CarlFK/pj/README.md

Pi JTAG hatish.
<https://github.com/CarlFK/pj/wiki>
rn_image_picker_lib_temp_75ff1ffa-18d0-46a6-9b67-185ed4aa6dda
