CarlFK/pj/project/pj.kicad_pcb

## KiCad design project/pj.kicad_pcb (2024-12-12)

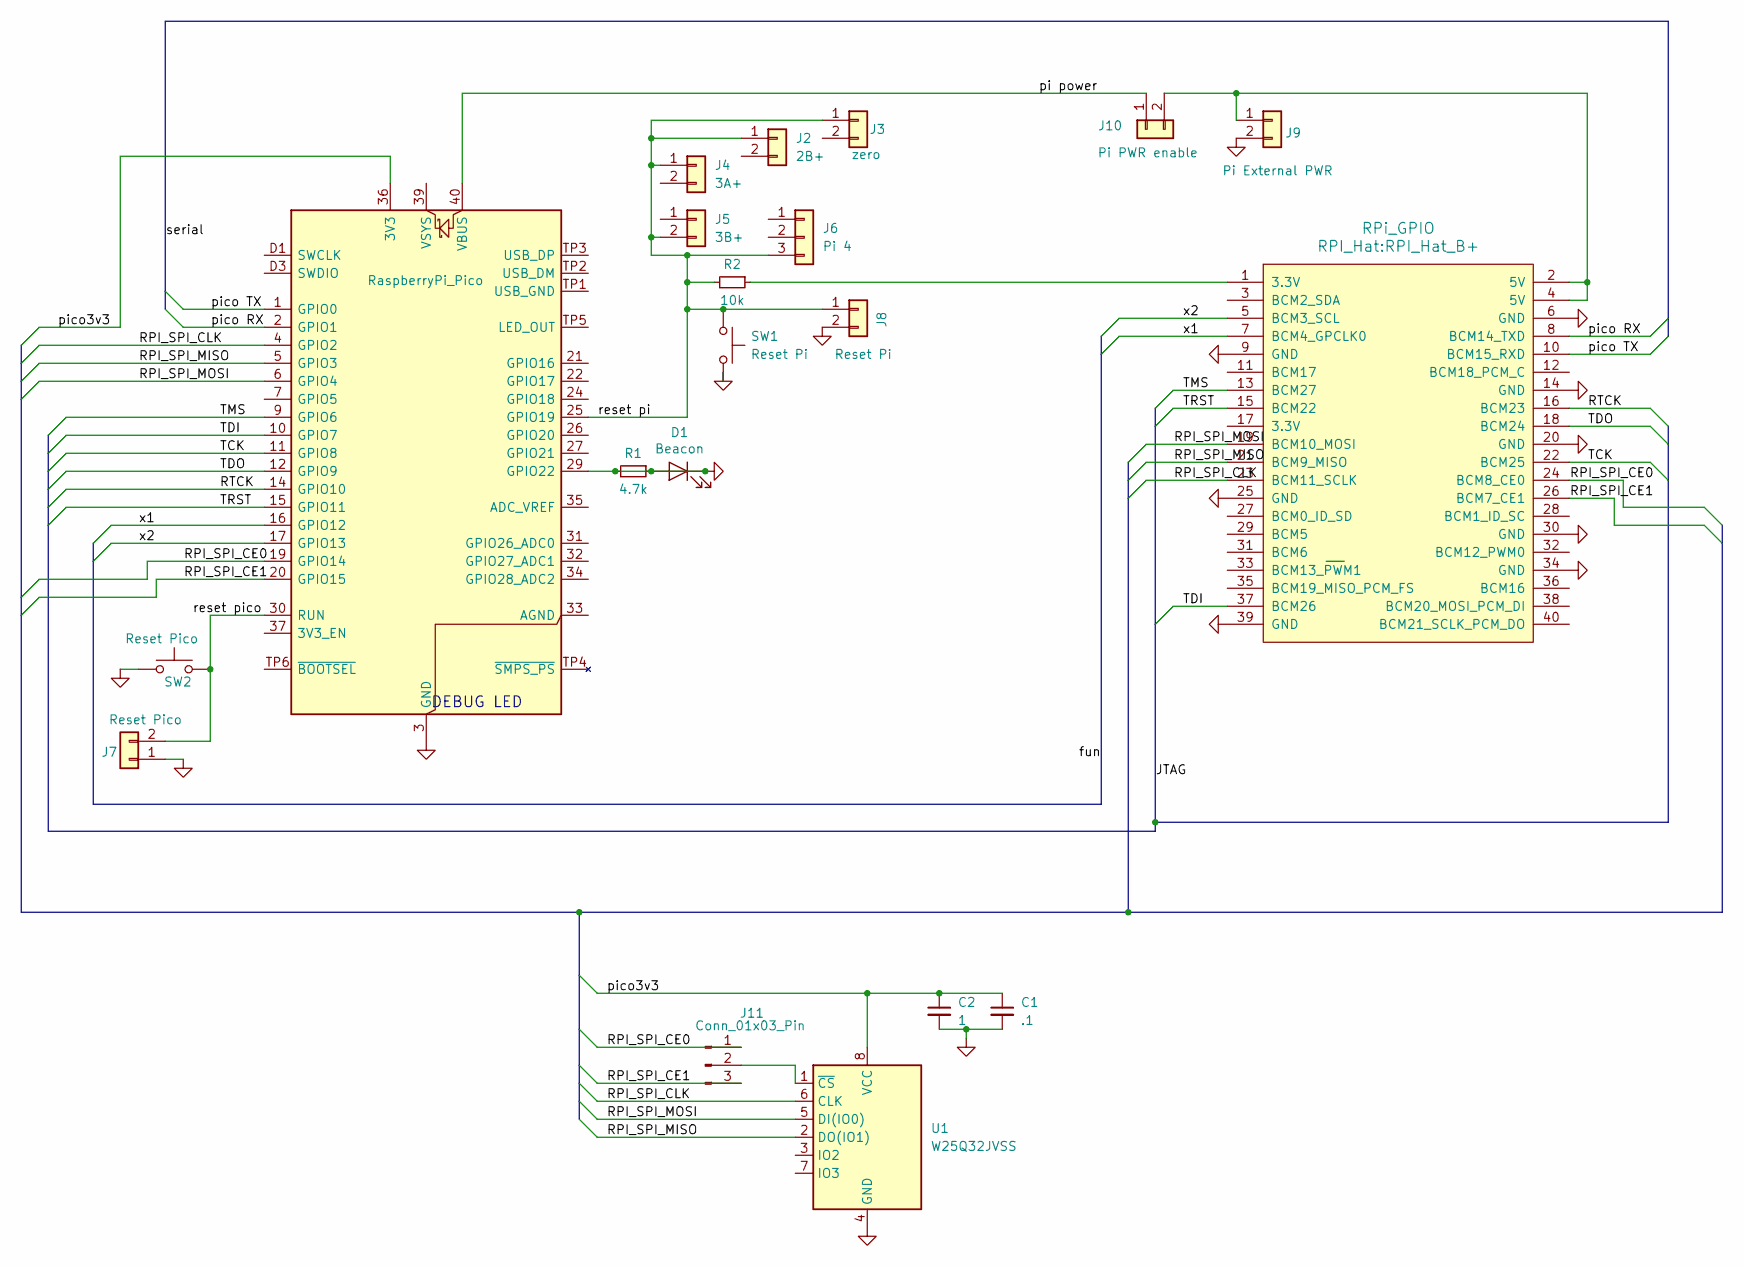
[picture p1: schematic pj.kicad_sch]

Parts:
A1: RaspberryPi_Pico; RaspberryPi_Pico_Common
C1: .1; C_0603_1608Metric_Pad1.08x0.95mm_HandSolder
C2: 1; C_0603_1608Metric_Pad1.08x0.95mm_HandSolder
D1: Beacon; LED_0603_1608Metric
J1: RPi_GPIO; RPI_Hat_B+
J2: 2B+; PinSocket_1x02_P2.54mm_Vertical
J3: zero; PinSocket_1x02_P2.54mm_Vertical
J4: 3A+; PinSocket_1x02_P2.54mm_Vertical
J5: 3B+; PinSocket_1x02_P2.54mm_Vertical
J6: Pi 4; PinSocket_1x03_P2.54mm_Vertical
J7: Reset Pico; PinHeader_1x02_P2.54mm_Vertical
J8: Reset Pi; PinHeader_1x02_P2.54mm_Vertical
J9: Pi External PWR; PinHeader_1x02_P2.54mm_Vertical
J10: Pi PWR enable; SolderJumper-2_P1.3mm_Bridged2Bar_Pad1.0x1.5mm
J11: Conn_01x03_Pin; PinHeader_1x03_P2.54mm_Vertical
R1: 4.7k; R_0603_1608Metric
R2: 10k; R_0603_1608Metric
SW1: Reset Pi; SW_PUSH_6mm_H4.3mm
SW2: Reset Pico; SW_PUSH_6mm_H4.3mm
U1: W25Q32JVSS; SOIC-8_5.23x5.23mm_P1.27mm

Connections:
/RPI_SPI_CE0: A1.19 (GPIO14), J1.24 (BCM8_CE0), J11.1
/RPI_SPI_CE1: A1.20 (GPIO15), J1.26 (BCM7_CE1), J11.3
/RPI_SPI_CLK: A1.4 (GPIO2), J1.23 (BCM11_SCLK), U1.6 (CLK)
/RPI_SPI_MISO: A1.5 (GPIO3), J1.21 (BCM9_MISO), U1.2 (DO(IO1))
/RPI_SPI_MOSI: A1.6 (GPIO4), J1.19 (BCM10_MOSI), U1.5 (DI(IO0))
/RTCK: A1.14 (GPIO10), J1.16 (BCM23)
/TCK: A1.11 (GPIO8), J1.22 (BCM25)
/TDI: A1.10 (GPIO7), J1.37 (BCM26)
/TDO: A1.12 (GPIO9), J1.18 (BCM24)
/TMS: A1.9 (GPIO6), J1.13 (BCM27)
/TRST: A1.15 (GPIO11), J1.15 (BCM22)
/pi power: A1.40 (VBUS), J10.1
/pico3v3: A1.36 (3V3), C1.1, C2.1, U1.8 (VCC)
/pico RX: A1.2 (GPIO1), J1.8 (BCM14_TXD)
/pico TX: A1.1 (GPIO0), J1.10 (BCM15_RXD)
/reset pi: A1.25 (GPIO19), J2.1, J3.1, J4.1, J5.2, J6.3, J8.1, R2.2, SW1.1
/x1: A1.16 (GPIO12), J1.7 (BCM4_GPCLK0)
/x2: A1.17 (GPIO13), J1.5 (BCM3_SCL)
GND: A1.3 (GND), A1.8 (GND), A1.13 (GND), A1.18 (GND), A1.23 (GND), A1.28 (GND), A1.29 (GPIO22), A1.38 (GND), A1.D2 (GND), C1.2, C2.2, D1.1 (K), D1.2 (A), J1.6 (GND), J1.9 (GND), J1.14 (GND), J1.20 (GND), J1.25 (GND), J1.30 (GND), J1.34 (GND), J1.39 (GND), J7.1, J8.2, J9.2, R1.1, R1.2, SW1.2, SW2.1, U1.4 (GND)
unnamed: A1.30 (RUN), J7.2, SW2.2
unnamed: J1.1 (3.3V), R2.1
unnamed: J1.2 (5V), J1.4 (5V), J9.1, J10.2
unnamed: J11.2, U1.1 (~CS)

Notes on the sheet:
DEBUG LED

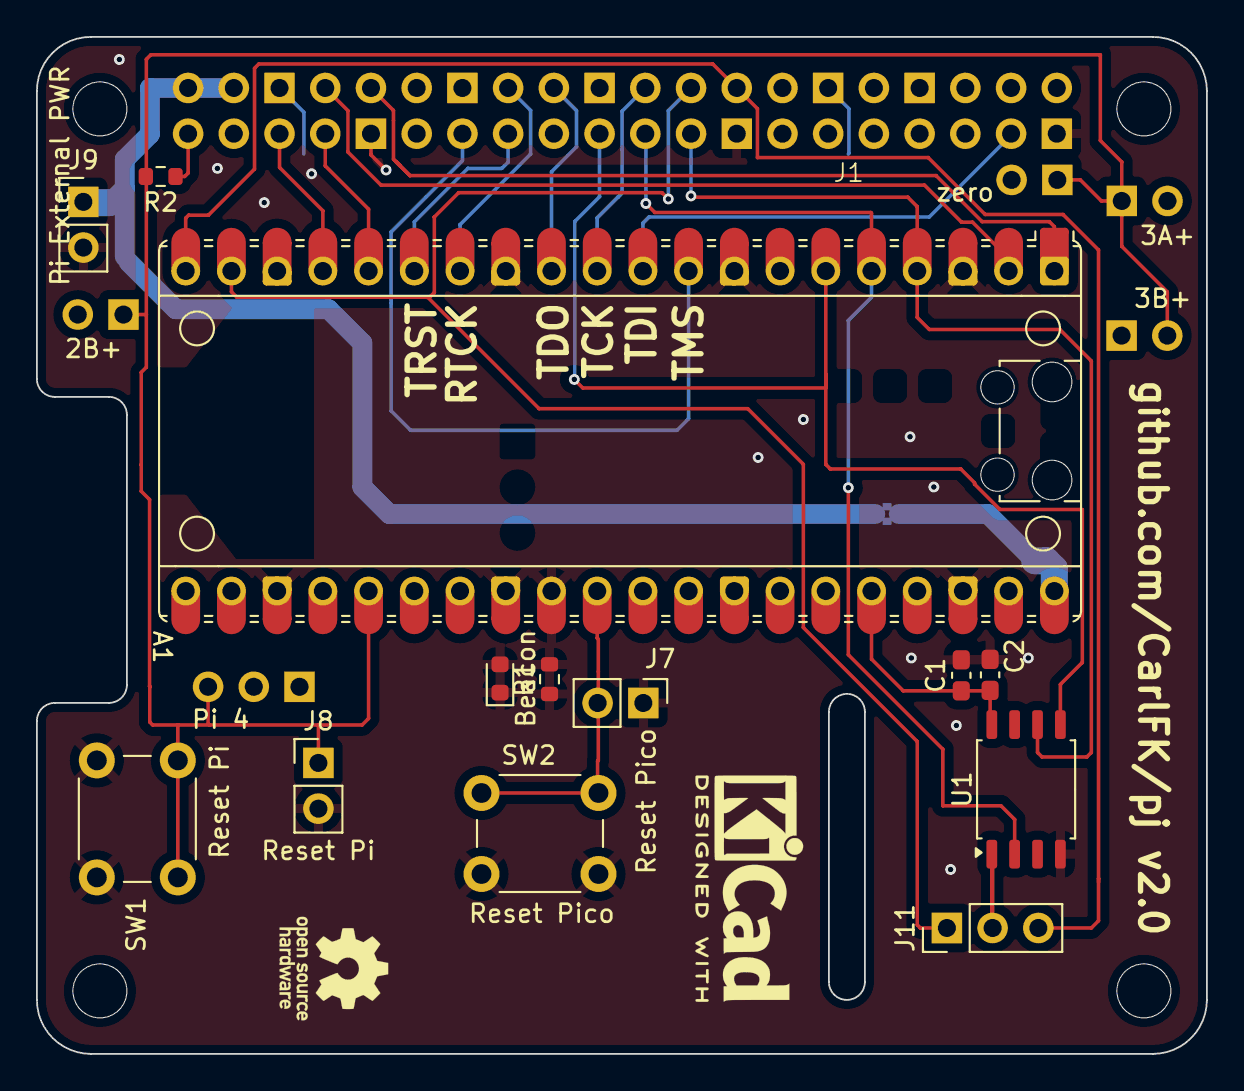
[picture p2: board pj.kicad_pcb from above]

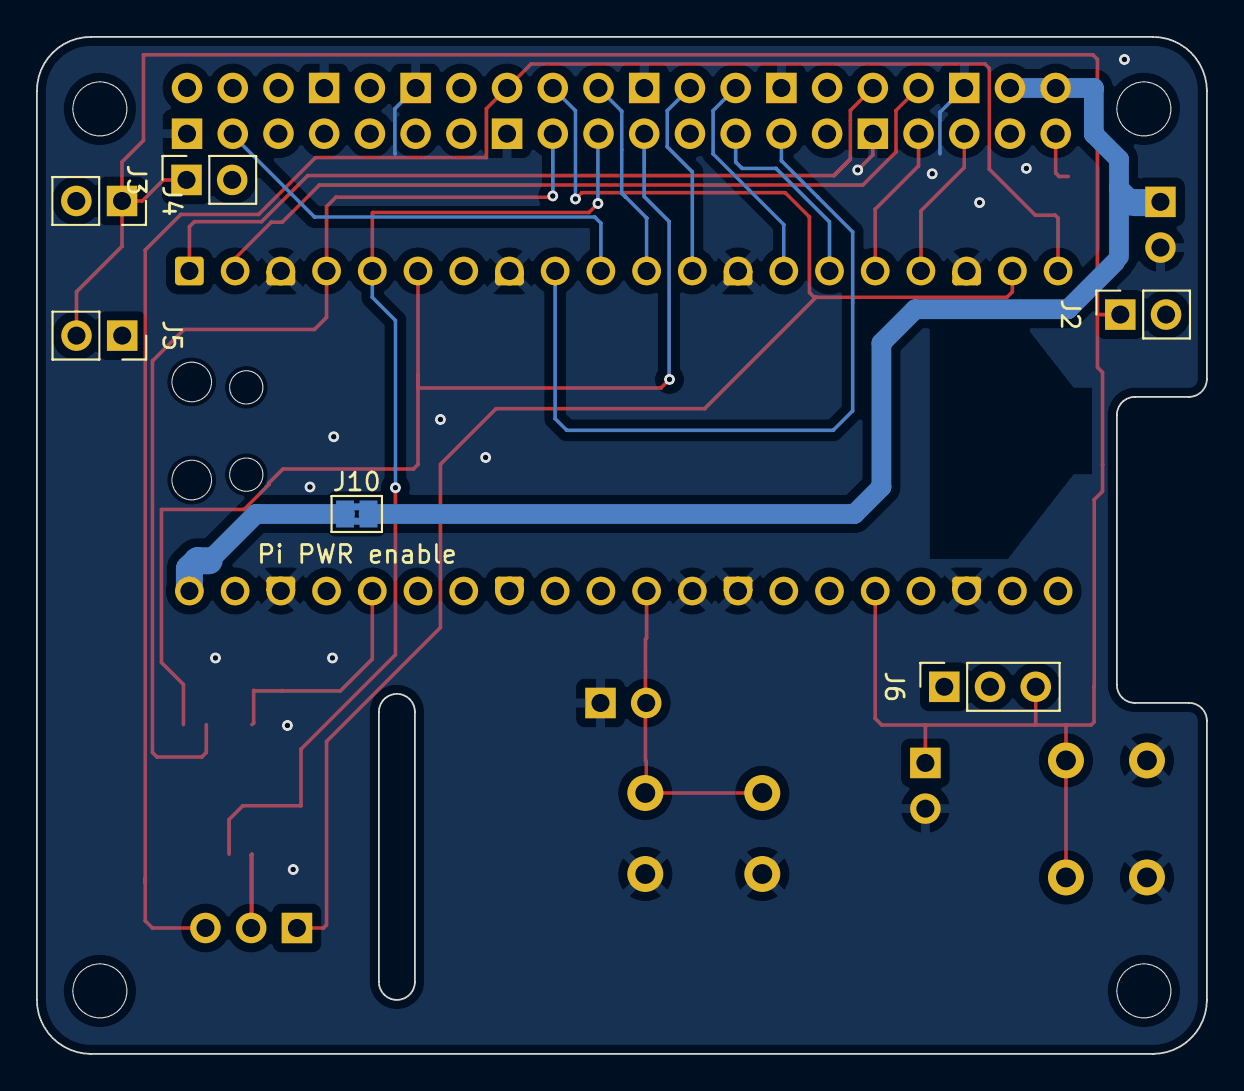
[picture p3: board pj.kicad_pcb from below]

Board: 2 copper layers, 65.0 x 56.5 mm, 20 parts (6 on the bottom side), 23 nets.
