CarlFK/pj/(threads)

Thread 3 (2024-11-04):

pi5 debug pins

CarlFK, 2024-11-04:
pcb change

<https://datasheets.raspberrypi.com/debug/debug-connector-specification.pdf>
```
for the pi5, all debug has moved to SWD, the tiny 3-pin connector between the 2 hdmi ports
by default, its in uart mode
but enable_jtag_gpio=1 puts it into SWD mode instead
if you had a matching 3pin JST-SH connector on your board, wired to any pico hw uart (on any unused pair of pins), then the board can debug a pi5 as well
as a random example, pin 1 on the JST is rx, pin 3 is TX (RPF defines this part, check the linked pdf)

if you wire pin1 of that, to gpio4 of the pico
and pin3 to gpio5

then hw uart1 can be used to get a serial shell on the pi5
and GPIO/PIO can be used to get SWD on the same pins
this will also work on 8/9, 12/13, 16/17, 20/21, ....
<https://www.sparkfun.com/products/21802>
Raspberry Pi Debug Probe
The Raspberry Pi Debug Probe is an inexpensive, all-in-one USB to serial debug and UART bridge.
Image
this can also do the same thing, its already got an rp2040, and the right connectors, but it only does serial and swd, no jtag
by adding the right connector, and sourcing a JST-SH cable, your board can do the same job, and then debug anything in the pi0-pi5 family
```

Thread 4 (2024-11-04):

zero run pins are in the wrong place

CarlFK, 2024-11-04:
The zero seems to be on the wrong side.

I'm not sure where I got the location from.

<https://datasheets.raspberrypi.com/rpizero/raspberry-pi-zero-mechanical-drawing.pdf>

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

Thread 5 (2024-11-04):

more power headers

CarlFK, 2024-11-04:
In case we want to feed in external power, it would be handy to have a 2nd power header so one 5v connection can feed and then daisy chain to the neighbors.

maybe a better connector too.

cleverca22, 2024-11-12:
it would also help to have a way to isolate the 5v of the pico from the 5v of the rpi

then you can power the rpi via its normal usb port, with a normal rpi psu

Closed 2024-12-12.

Thread 7 (2024-11-04):

move uart to uart1 pin 26,27

CarlFK, 2024-11-04:
re-using 0/1 would mean the debug header is cross-connected to gpio14/15, and then they could conflict at the electrical level

oh, but maybe avoid uart0 then

if you avoid uart0, then you can drive both uart's at once

cleverca22, 2024-11-12:
but now that ive delt with the pico-sdk stdio stuff, i can see how i could easily move things to uart1
so this is a lower priority

Thread 10 (2024-11-16):

Add SPI flash to boot from

CarlFK, 2024-11-16:
To be able to test stage1 stuff on the open firmware, stage1 must be on one of the 7 sources listed above
and we need a way to remotely replace the stage1 binary
that's where the SPI flash stuff i mentioned comes into play

<https://github.com/librerpi/rpi-open-firmware/blob/master/docs/rom.txt#L21-L23>

```
5: spi0 boot, enabled by bits 30-31 being non-zero
    bit 30-31, 1==GPIO7-11=ALT0, 2==GPIO35-39=ALT0, 3==GPIO46-49=ALT2(undocumented altmode)
    not confirmed 100%, but it looks very similar to rpi4, a 0x55aaf00f magic, length prefix, then raw bootcode.bin
```

for SPI boot, you need to set bits 30/31 of OTP register 17 (edited)

you then load an SPI image, that starts with 0x55aaf00f, a 32bit length, and then $length bytes of your stage1 binary (bootcode.bin is the usual name for it)

when the pi turns on, it will check every enabled boot source in the order listed in rom.txt

sd is first, SPI is in the middle, usb is near the end

so if bootcode.bin cant be found on the SD card, it will check for the 0x55aaf00f in SPI

and if found, it will execute the stage1 binary in the SPI flash chip

the exact value of bits 30/31, configures which gpio pins the SPI flash will be on

putting 1<<30 into reg17, will set it to use gpio 7-11
2<<30 is gpio 35-39 (not usable on the rpi boards)
and 3<<30 is gpio 46-49 (also not usable) (edited)

its basically identical to how the pi4 boots from SPI

the special thing in this case, is that you can share the SPI between both the rpi and pico, and re-flash the spi remotely via the pico

or just omit the SPI flash entirely, and have the pico emulate it

the official stage1 binary doesnt support booting from SPI flash, and thats what they mean when they say "GPU support"

gpio 7-11, in alt0

<https://cdn.discordapp.com/attachments/1304955329053720626/1306870137906921542/image.png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>

(more coming soon)

cleverca22, 2024-11-16:
https://github.com/CarlFK/pj/pull/9
this PR partially adds support to the schematic

there is a portion at the bottom for an SPI flash chip such as https://www.sparkfun.com/products/15809

MOSI goes to DI
MISO goes to DO
CLK to CLK
CE0/CE1 go to the sides of a 3x1 0.1" header, the center goes to CS
HOLD and WP get pullups to vcc
VCC is 3.3v

my kicad footprint library is broken, so i cant add new parts to the schematic

Thread 13 (2025-01-13):

spi CS needs a pull-up

cleverca22, 2025-01-13:
when the 3 pin CS jumper is not fitted, that leaves the CS pin of the SPI flash floating

the CS pin needs a pull-up resistor to 3.3v to keep the flash inactive when un-addressed

Thread 14 (2025-03-18):

spi flash footprint too wide

CarlFK, 2025-03-18:
"pick a narrower one"
