CarlFK/pj/pi/config.txt

uart_2ndstage=1
enable_jtag_gpio=1
enable_uart=1
dtoverlay=disable-bt
