CarlFK/pj/(commit log)

2024-10-22 jtag, uart, power.
    [jt.kicad_pcb, jt.kicad_sch]
2024-10-22 add ki-lime-pi-pico submodule
2024-10-23 Add all the RUNs
    [jt.kicad_sch]
2024-10-23 burn down the pdb. try again.
    [jt.kicad_pcb, jt.kicad_sch, pj.kicad_pcb, pj.kicad_sch]
2024-10-23 connected vcc, tx/rx and added the headers to the pcb.
    [pj.kicad_pcb, pj.kicad_sch]
2024-10-24 all symbols linked to PCB
    [pj.kicad_pcb, pj.kicad_sch]
2024-10-24 now with reset buttons
    [pj.kicad_pcb, pj.kicad_sch]
2024-10-24 now with grounds
    [pj.kicad_pcb, pj.kicad_sch]
2024-10-24 RUN button GND
    [pj.kicad_pcb, pj.kicad_sch]
2024-10-24 fix cruft on J8 pin 2
    [pj.kicad_pcb, pj.kicad_sch]
2024-10-24 ground plane on both sides
    [pj.kicad_pcb, pj.kicad_sch]
2024-10-24 Add Pico PWR and External PoWR
    [pj.kicad_sch]
2024-10-25 pwr eneble
    [pj.kicad_pcb, pj.kicad_sch]
2024-10-25 re-route power for more power
    [pj.kicad_pcb]
2024-10-25 tweek the RUN holes
    [pj.kicad_pcb]
2024-10-25 add JTAG pin labels
    [pj.kicad_pcb]
2024-10-25 oshw logo
    [pj.kicad_pcb]
2024-10-25 add gpio bus, lables and KiCad logo
    [pj.kicad_pcb, pj.kicad_sch]
2024-10-26 added 40 pin socket
    [pj.kicad_pcb]
2024-10-26 group jtag io
    [pj.kicad_pcb, pj.kicad_sch]
2024-10-26 move the pi reset jumper/button schematic
    [pj.kicad_sch]
2024-10-26 hook some gpios for kicks
    [pj.kicad_pcb, pj.kicad_sch]
2024-10-26 move holes to make room for more holes
    [pj.kicad_pcb]
2024-10-26 move reset over one, move reset headert to make room for row of holes.
    [pj.kicad_pcb, pj.kicad_sch]
2024-10-26 add 16 holes to put things in later.
    [pj.kicad_pcb, pj.kicad_sch]
2024-10-26 ground plane, reroute some reset
    [pj.kicad_pcb]
2024-10-26 add missing connection to hole.
    [pj.kicad_pcb, pj.kicad_sch]
2024-10-26 no DRC errors
    [pj.kicad_pcb]
2024-10-26 2.54 for all the headers.
    [pj.kicad_pcb, pj.kicad_sch]
2024-10-26 set f.silk, again.
    [pj.kicad_pcb]
2024-10-26 set a few more f.silk, again.
    [pj.kicad_pcb]
2024-10-27 busses everywere. with better labels.
    [pj.kicad_pcb, pj.kicad_sch]
2024-10-27 lable the serial bus
    [pj.kicad_sch]
2024-10-28 document source of kicad_parser
2024-10-29 label buses jtag and fun
    [pj.kicad_pcb, pj.kicad_sch]
2024-10-29 change serial bus label to global.
    [pj.kicad_sch]
2024-10-29 change global labels to local.
    [pj.kicad_sch]
2024-11-15 start adding SPI flash
    [pj.kicad_sch]
2024-11-30 spi sch
    [pj.kicad_pcb, pj.kicad_sch]
2024-12-11 add spi symbol
    [pj.kicad_pcb, pj.kicad_sch]
2024-12-11 removing debug header
    [pj.kicad_pcb, pj.kicad_sch]
2024-12-12 added spi, moved zero run
    [pj.kicad_pcb, pj.kicad_sch]
2024-12-12 done with spi
    [pj.kicad_pcb, pj.kicad_sch]
2024-12-12 move OH logo, remove some extra vias
    [pj.kicad_pcb]
